jbayaux/embedded/Schematics/bluetooth_module.jpg

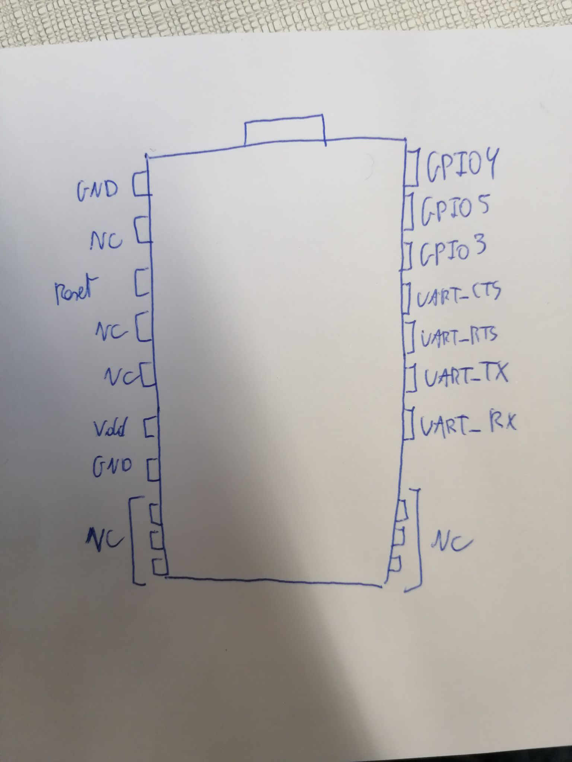
Schematics/bluetooth_module.jpg
