jbayaux/embedded/Schematics/hardware-with-flash/Projet_schematics_flash.pdf

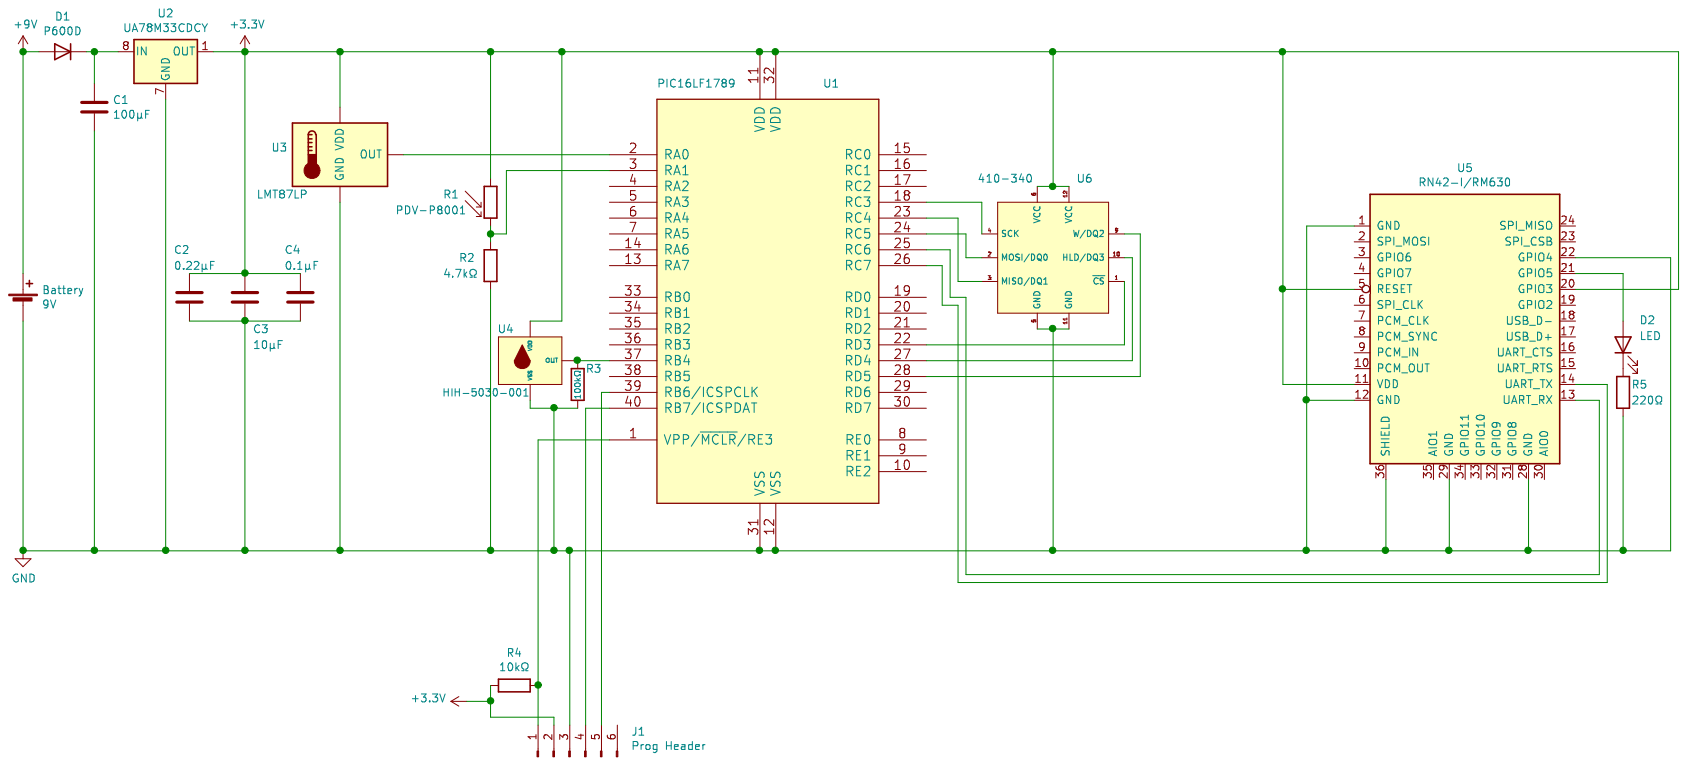
[picture p13: page 1]
