jbayaux/embedded/Schematics/hardware/Projet_schematics.pdf

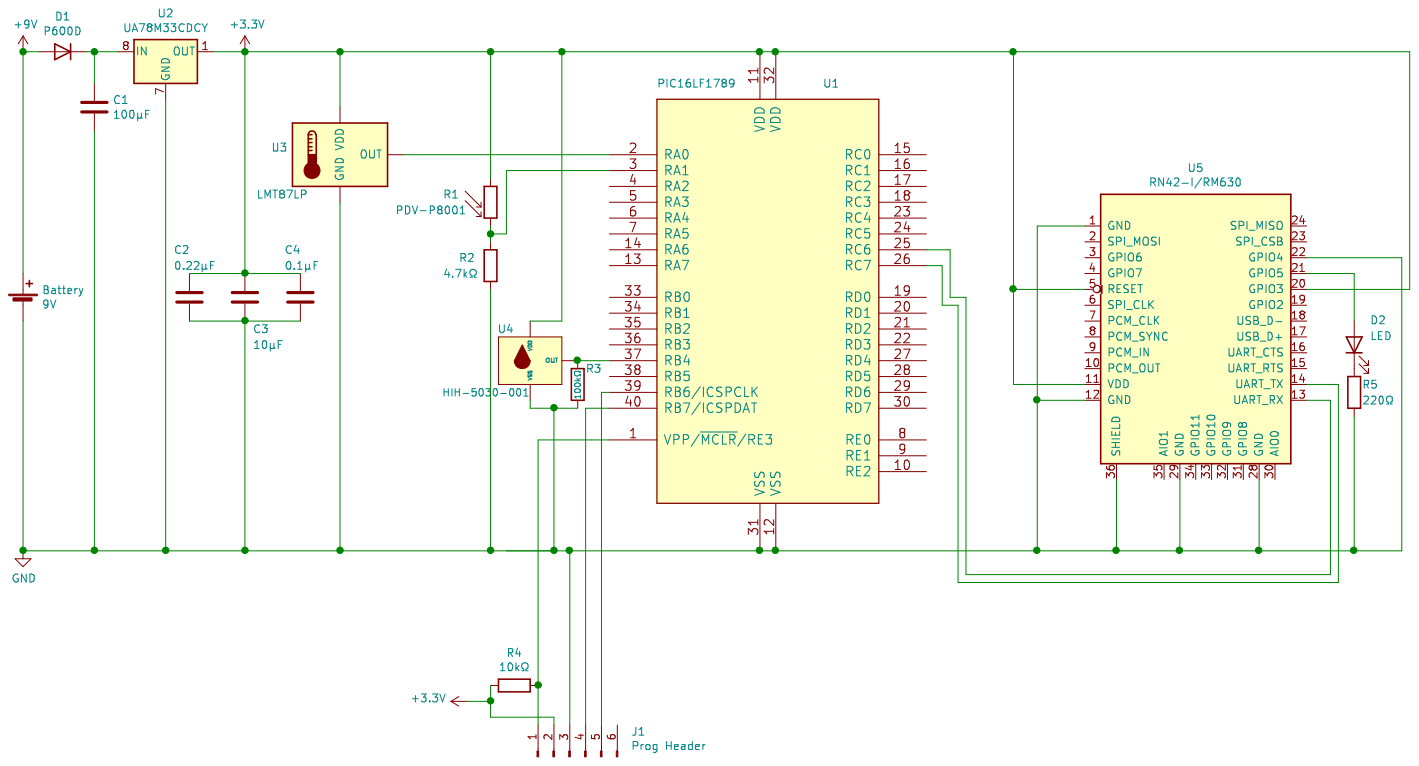
[picture p14: page 1]
