jbayaux/embedded/Schematics/hardware-with-flash/Projet_schematics.sch

## KiCad design Schematics/hardware-with-flash/Projet_schematics.sch (2021-05-11)

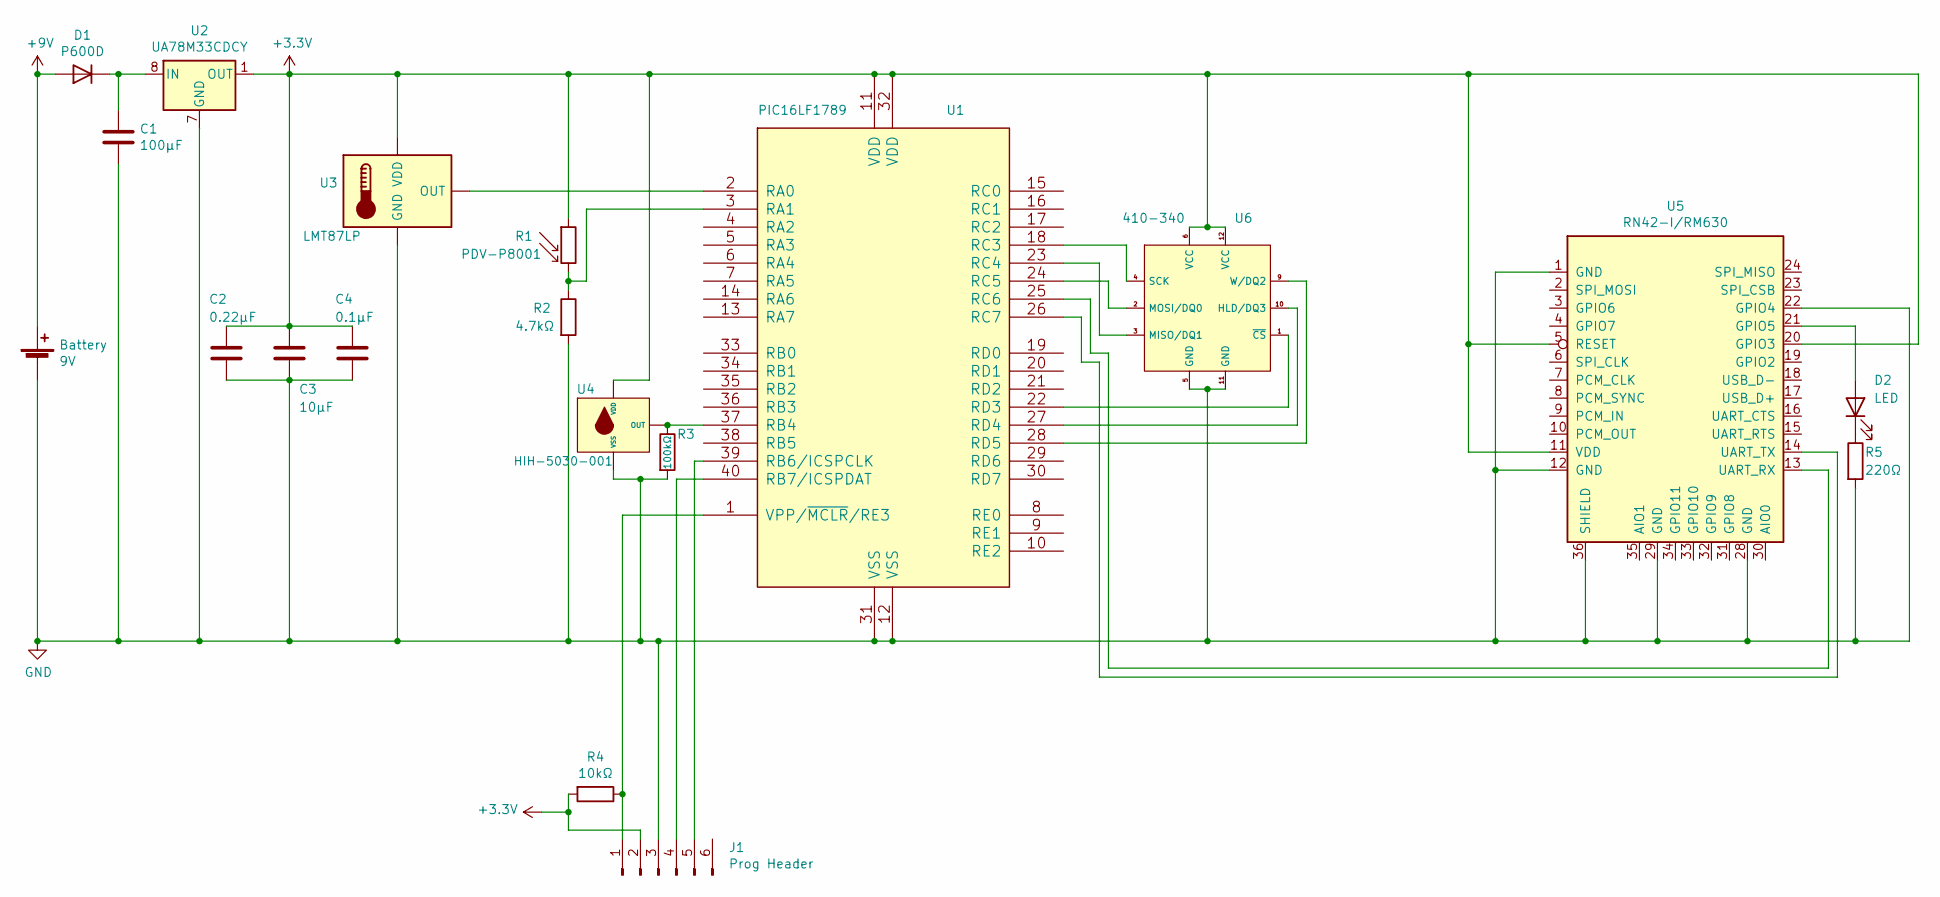
[picture p15: schematic Projet_schematics.sch]

Parts:
Battery: 9V
C1: 100µF
C2: 0.22µF
C3: 10µF
C4: 0.1µF
D1: P600D
D2: LED
J1: Prog Header
R1: PDV-P8001
R2: 4.7kΩ
R3: 100kΩ
R4: 10kΩ
R5: 220Ω
U1: PIC16LF1789
U2: UA78M33CDCY; SOIC-8_3.9x4.9mm_P1.27mm
U3: LMT87LP; SOT-353_SC-70-5
U4: HIH-5030-001
U5: RN42-I/RM630; RN42
U6: 410-340

Connections:
+3.3V: C2.1, C3.1, C4.1, J1.2, R1.1, R4.2, U1.11 (VDD), U1.32 (VDD), U2.1 (OUT), U3.~, U4.~, U5.5 (RESET), U5.11 (VDD), U5.20 (GPIO3), U6.6 (VCC), U6.12 (VCC)
+9V: Battery.1 (+), D1.2 (A)
GND: Battery.2 (-), C1.2, C2.2, C3.2, C4.2, J1.3, R2.2, R3.2, R5.2, U1.12 (VSS), U1.31 (VSS), U2.2 (GND), U2.3 (GND), U2.6 (GND), U2.7 (GND), U3.~, U4.~, U5.1 (GND), U5.12 (GND), U5.22 (GPIO4), U5.28 (GND), U5.29 (GND), U5.36 (SHIELD), U6.5 (GND), U6.11 (GND)
unnamed: C1.1, D1.1 (K), U2.8 (IN)
unnamed: D2.1 (K), R5.1
unnamed: D2.2 (A), U5.21 (GPIO5)
unnamed: J1.1, R4.1, U1.1 (VPP/~MCLR~/RE3)
unnamed: J1.4, U1.40 (RB7/ICSPDAT)
unnamed: J1.5, U1.39 (RB6/ICSPCLK)
unnamed: R1.2, R2.1, U1.3 (RA1)
unnamed: R3.1, U1.37 (RB4), U4.~
unnamed: U1.2 (RA0), U3.~
unnamed: U1.18 (RC3), U6.4 (SCK)
unnamed: U1.22 (RD3), U6.1 (~CS)
unnamed: U1.23 (RC4), U6.3 (MISO/DQ1)
unnamed: U1.24 (RC5), U6.2 (MOSI/DQ0)
unnamed: U1.25 (RC6), U5.13 (UART_RX)
unnamed: U1.26 (RC7), U5.14 (UART_TX)
unnamed: U1.27 (RD4), U6.10 (HLD/DQ3)
unnamed: U1.28 (RD5), U6.9 (W/DQ2)
