jbayaux/embedded/(commit log)

2021-02-19 Add electronic schematics
    [Projet_schematics.sch]
2021-04-23 Youhouuuu la flash marche !!
2021-04-23 Add bluetooth module schematics
    [Projet_schematics.sch]
2021-04-23 Add pics from oscillo for flash
    [F0000CH1.CSV, F0000CH2.CSV, F0001CH1.CSV, F0001CH2.CSV, F0002CH1.CSV, F0002CH2.CSV, F0003CH1.CSV, F0003CH2.CSV]
2021-05-07 Test projects with and without flash
    - flash-test
    > write into/read to volatile status register
    > program/read commands
    - store-in-ram
    > store adc results into PIC memory
2021-05-07 Add luminosity sensor + sleep mode
2021-05-11 Set timer to 15 min
2021-05-11 Update shematics
    [Projet_schematics.sch]
2021-05-14 Remove oscillo and add Conversion.pdf
    [F0000CH1.CSV, F0000CH2.CSV, F0001CH1.CSV, F0001CH2.CSV, F0002CH1.CSV, F0002CH2.CSV, F0003CH1.CSV, F0003CH2.CSV]
